AssociationRobotTelecomStrasbourg/effective-pancake/hardware/pdf/effective-pancake-lidar.pdf

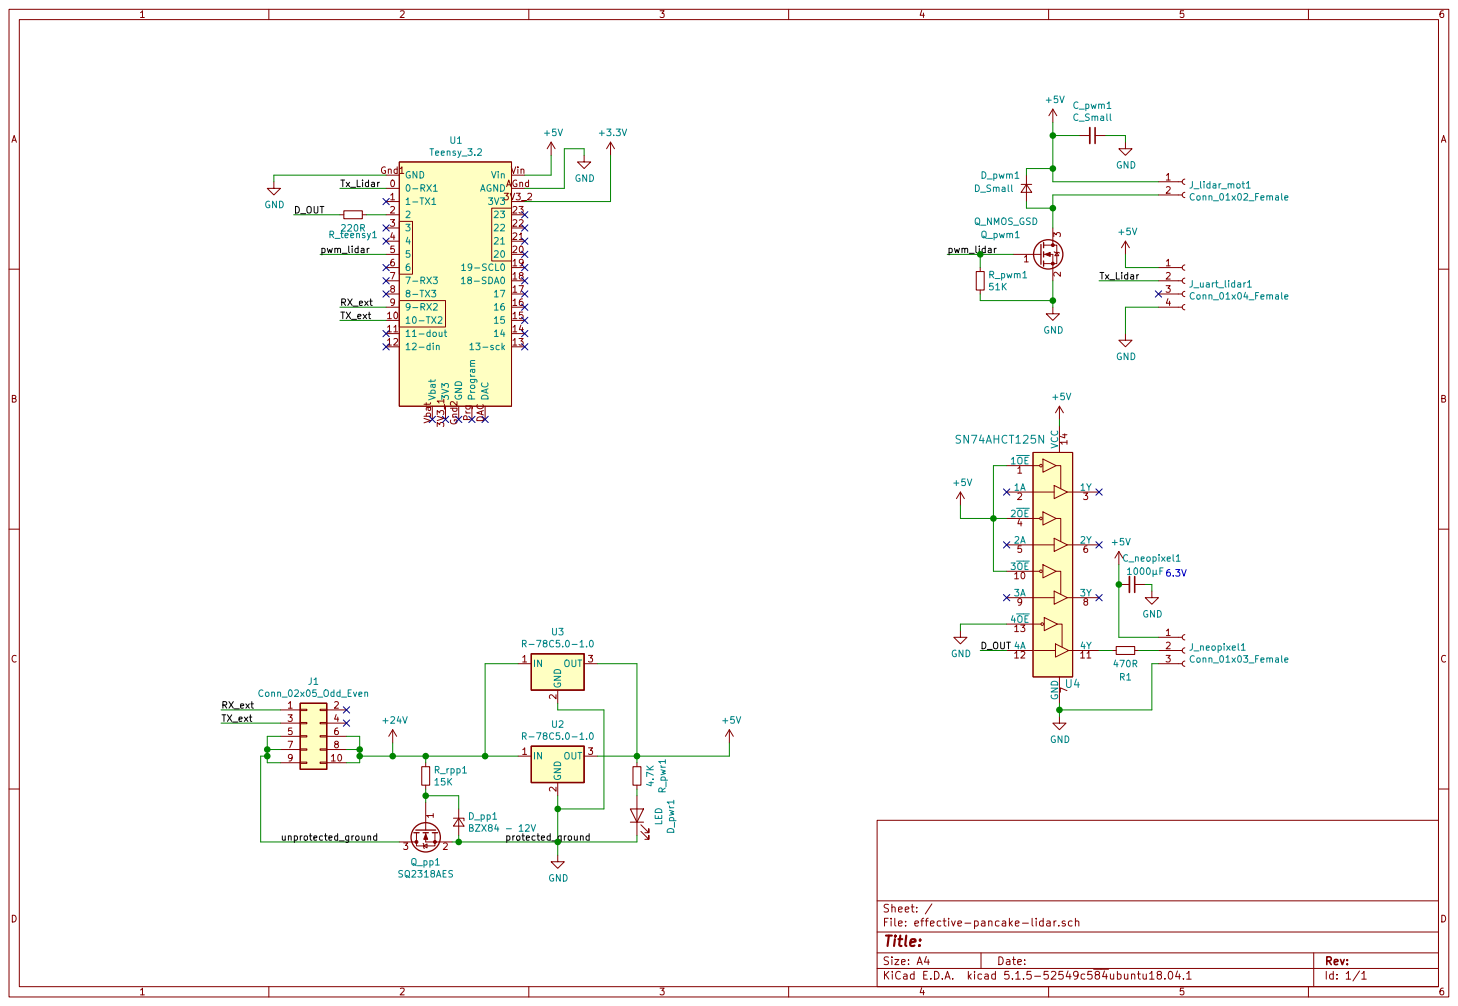
[picture p1: page 1]

File: effective-pancake-lidar.sch Sheet: /
