AssociationRobotTelecomStrasbourg/effective-pancake/hardware/pdf/effective-pancake-motherboard.pdf

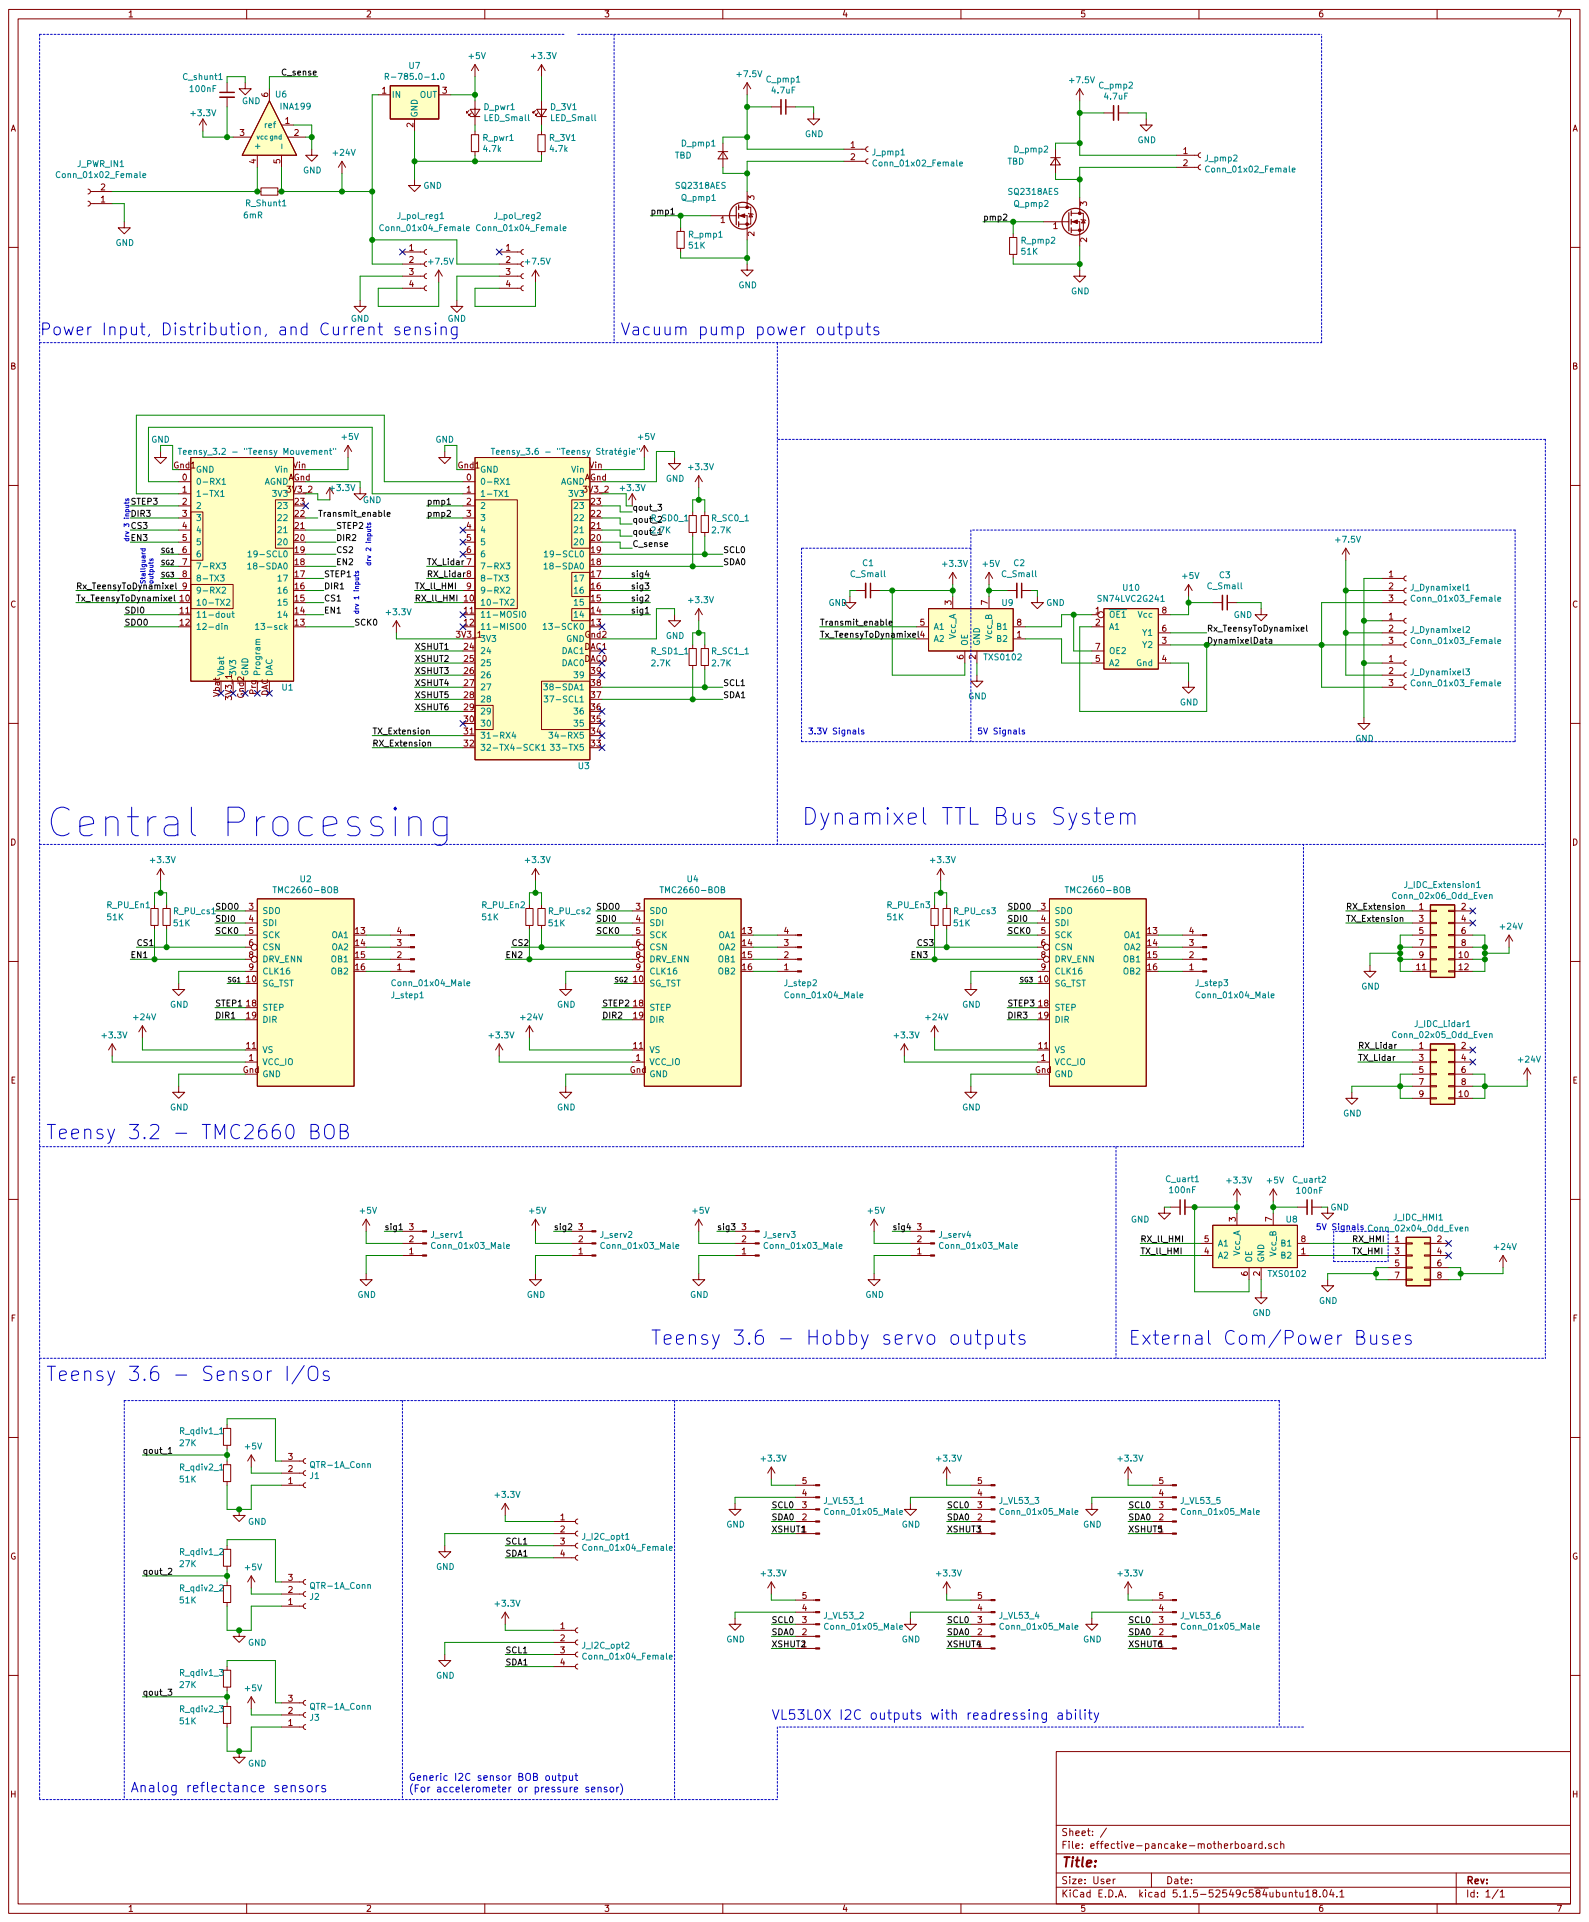
[picture p2: page 1]

Power Input, Distribution, and Current sensing drv 3 inputs

Vacuum pump power outputs

Teensy 3.6 - Hobby servo outputs drv 1 inputs

Dynamixel TTL Bus System

File: effective-pancake-motherboard.sch Sheet: / R_qdiv2_1

VL53L0X I2C outputs with readressing ability
