AssociationRobotTelecomStrasbourg/effective-pancake/hardware/pdf/effective-pancake-HMI.pdf

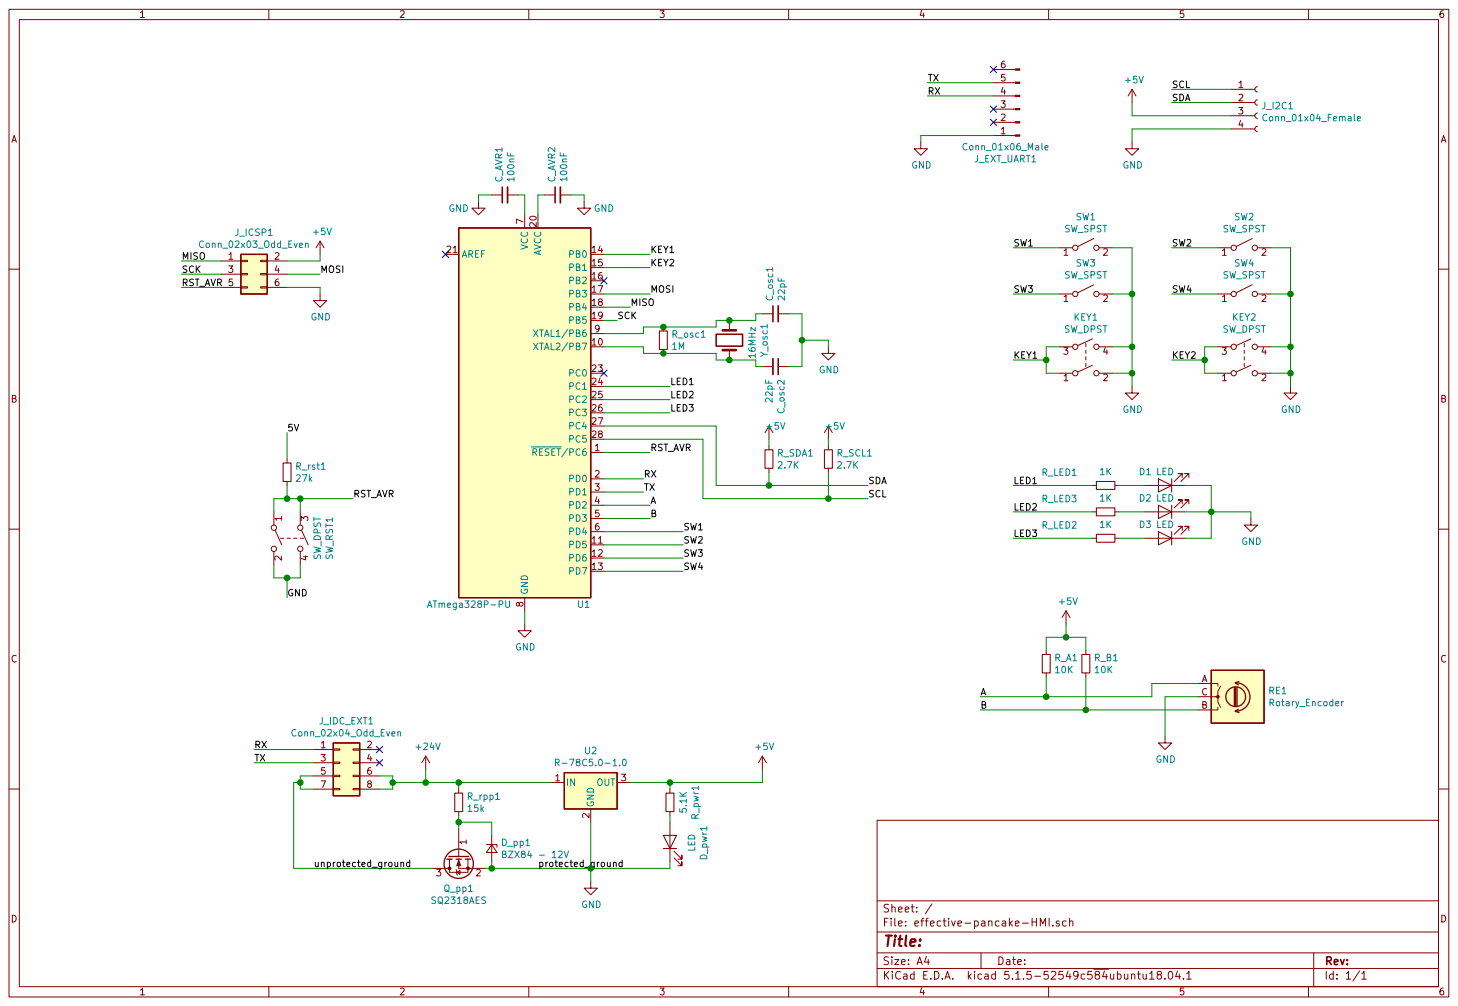
[picture p3: page 1]

File: effective-pancake-HMI.sch Sheet: /
Id: 1/1 Title:
