AssociationRobotTelecomStrasbourg/effective-pancake/hardware/effective-pancake-motherboard/effective-pancake-motherboard.kicad_pcb

## KiCad design hardware/effective-pancake-motherboard/effective-pancake-motherboard.kicad_pcb (2020-01-04)

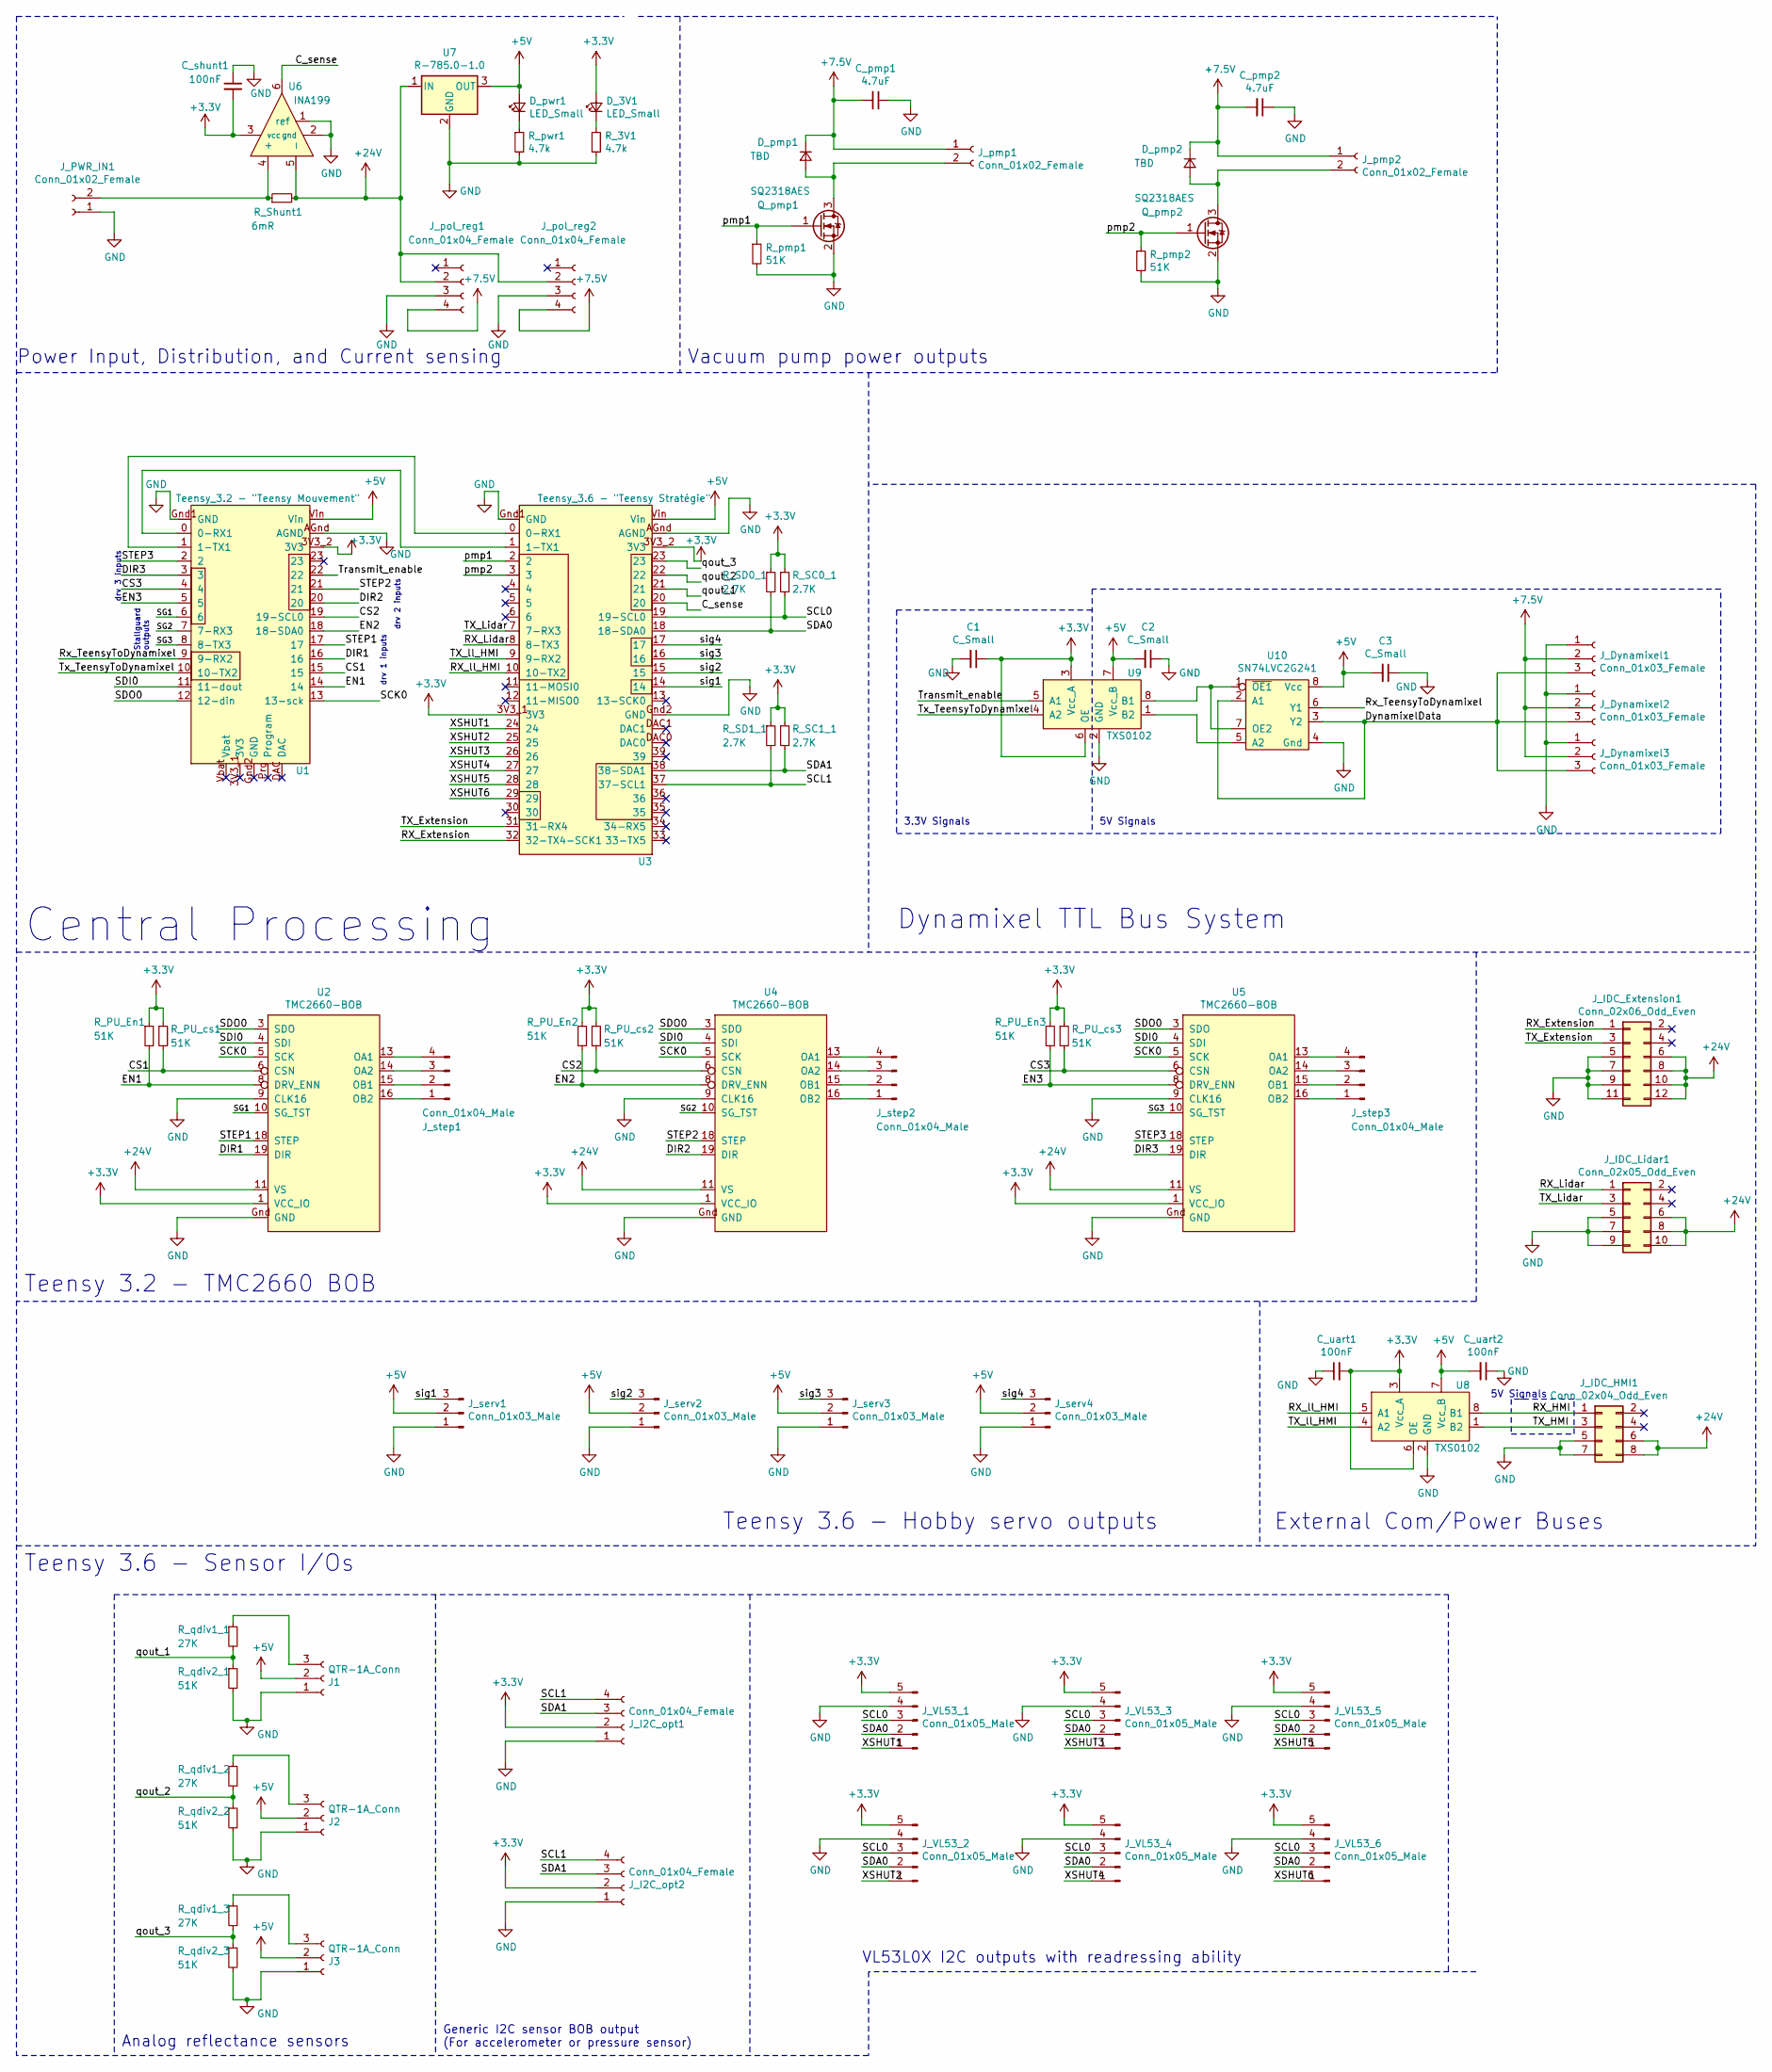
[picture p4: schematic effective-pancake-motherboard.sch]

Parts:
C1, C2, C3: C_Small; C_0805_2012Metric_Pad1.15x1.40mm_HandSolder
C_pmp1, C_pmp2: 4.7uF; C_Radial_D4.0mm_H7.0mm_P1.50mm
C_shunt1: 100nF; C_0805_2012Metric_Pad1.15x1.40mm_HandSolder
C_uart1, C_uart2: 100nF; C_0805_2012Metric_Pad1.15x1.40mm_HandSolder
D_3V1: LED_Small; LED_1206_3216Metric_Castellated
D_pmp1, D_pmp2: TBD; D_1206_3216Metric
D_pwr1: LED_Small; LED_1206_3216Metric_Castellated
J1, J2, J3: QTR-1A_Conn; PinHeader_1x03_P2.54mm_Vertical
J_Dynamixel1, J_Dynamixel2, J_Dynamixel3: Conn_01x03_Female; Molex_Micro-Latch_53253-0370_1x03_P2.00mm_Vertical
J_I2C_opt1, J_I2C_opt2: Conn_01x04_Female; PinSocket_1x04_P2.54mm_Vertical
J_IDC_Extension1: Conn_02x06_Odd_Even; IDC-Header_2x06_P2.54mm_Vertical
J_IDC_HMI1: Conn_02x04_Odd_Even; IDC-Header_2x04_P2.54mm_Vertical
J_IDC_Lidar1: Conn_02x05_Odd_Even; IDC-Header_2x05_P2.54mm_Vertical
J_PWR_IN1: Conn_01x02_Female; PhoenixContact_MC_1,5_2-G-5.08_1x02_P5.08mm_Horizontal
J_VL53_1, J_VL53_2, J_VL53_3, J_VL53_4, J_VL53_5, J_VL53_6: Conn_01x05_Male; PinSocket_1x05_P2.54mm_Vertical
J_pmp1, J_pmp2: Conn_01x02_Female; JST_XH_B2B-XH-A_1x02_P2.50mm_Vertical
J_pol_reg1, J_pol_reg2: Conn_01x04_Female; PinSocket_1x04_P2.54mm_Vertical
J_serv1, J_serv2, J_serv3, J_serv4: Conn_01x03_Male; PinHeader_1x03_P2.54mm_Vertical
J_step1, J_step2, J_step3: Conn_01x04_Male; PinHeader_1x04_P2.54mm_Vertical
Q_pmp1, Q_pmp2: SQ2318AES; SOT-23
R_3V1: 4.7k; R_0805_2012Metric_Pad1.15x1.40mm_HandSolder
R_PU_En1, R_PU_En2, R_PU_En3: 51K; R_0805_2012Metric_Pad1.15x1.40mm_HandSolder
R_PU_cs1, R_PU_cs2, R_PU_cs3: 51K; R_0805_2012Metric_Pad1.15x1.40mm_HandSolder
R_SC0_1, R_SC1_1: 2.7K; R_0805_2012Metric_Pad1.15x1.40mm_HandSolder
R_SD0_1, R_SD1_1: 2.7K; R_0805_2012Metric_Pad1.15x1.40mm_HandSolder
R_Shunt1: 6mR; R_1206_3216Metric_Pad1.42x1.75mm_HandSolder
R_pmp1, R_pmp2: 51K; R_0805_2012Metric_Pad1.15x1.40mm_HandSolder
R_pwr1: 4.7k; R_0805_2012Metric_Pad1.15x1.40mm_HandSolder
R_qdiv1_1, R_qdiv1_2, R_qdiv1_3: 27K; R_0805_2012Metric_Pad1.15x1.40mm_HandSolder
R_qdiv2_1, R_qdiv2_2, R_qdiv2_3: 51K; R_0805_2012Metric_Pad1.15x1.40mm_HandSolder
U1: Teensy_3.2 - \"Teensy Mouvement\"; Teensy_3.2
U2, U4, U5: TMC2660-BOB
U3: Teensy_3.6 - \"Teensy Stratégie\"; Teensy_3.6
U6: INA199; Texas_R-PDSO-G6
U7: R-785.0-1.0; Converter_DCDC_RECOM_R-78E-0.5_THT
U8, U9: TXS0102; PDSO-G8
U10: SN74LVC2G241; PDSO-G8

Connections:
+3V3: C1.1, C_shunt1.2, C_uart1.2, D_3V1.2 (A), J_I2C_opt1.2, J_I2C_opt2.2, J_VL53_1.5, J_VL53_2.5, J_VL53_3.5, J_VL53_4.5, J_VL53_5.5, J_VL53_6.5, R_PU_En1.1, R_PU_En2.1, R_PU_En3.1, R_PU_cs1.1, R_PU_cs2.1, R_PU_cs3.1, R_SC0_1.1, R_SC1_1.1, R_SD0_1.1, R_SD1_1.1, U1.3V3_2 (3V3), U2.1 (VCC_IO), U3.3V3_1 (3V3), U3.3V3_2 (3V3), U4.1 (VCC_IO), U5.1 (VCC_IO), U6.3 (vcc), U8.3 (Vcc_A), U8.6 (OE), U9.3 (Vcc_A), U9.6 (OE)
+5V: C2.2, C3.2, C_uart2.2, D_pwr1.2 (A), J1.2, J2.2, J3.2, J_serv1.2, J_serv2.2, J_serv3.2, J_serv4.2, U1.Vin, U3.Vin, U7.3 (OUT), U8.7 (Vcc_B), U9.7 (Vcc_B), U10.8 (Vcc)
+7.5V: C_pmp1.2, C_pmp2.2, D_pmp1.1 (K), D_pmp2.1 (K), J_Dynamixel1.2, J_Dynamixel2.2, J_Dynamixel3.2, J_pmp1.1, J_pmp2.1, J_pol_reg1.4, J_pol_reg2.4
+24V: J_IDC_Extension1.6, J_IDC_Extension1.8, J_IDC_Extension1.10, J_IDC_Extension1.12, J_IDC_HMI1.6, J_IDC_HMI1.8, J_IDC_Lidar1.6, J_IDC_Lidar1.8, J_IDC_Lidar1.10, J_pol_reg1.2, J_pol_reg2.2, R_Shunt1.2, U2.11 (VS), U4.11 (VS), U5.11 (VS), U6.5 (-), U7.1 (IN)
/CS1: R_PU_cs1.2, U1.15, U2.6 (CSN)
/CS2: R_PU_cs2.2, U1.19 (19-SCL0), U4.6 (CSN)
/CS3: R_PU_cs3.2, U1.4, U5.6 (CSN)
/C_sense: U3.20, U6.6
/DIR1: U1.16, U2.19 (DIR)
/DIR2: U1.20, U4.19 (DIR)
/DIR3: U1.3, U5.19 (DIR)
/DynamixelData: J_Dynamixel1.3, J_Dynamixel2.3, J_Dynamixel3.3, U10.2 (A1), U10.3 (Y2)
/EN1: R_PU_En1.2, U1.14, U2.8 (DRV_ENN)
/EN2: R_PU_En2.2, U1.18 (18-SDA0), U4.8 (DRV_ENN)
/EN3: R_PU_En3.2, U1.5, U5.8 (DRV_ENN)
/RX_Extension: J_IDC_Extension1.1, U3.32 (32-TX4-SCK1)
/RX_HMI: J_IDC_HMI1.1, U8.8 (B1)
/RX_Lidar: J_IDC_Lidar1.1, U3.8 (8-TX3)
/RX_ll_HMI: U3.10 (10-TX2), U8.5 (A1)
/Rx_TeensyToDynamixel: U1.9 (9-RX2), U10.6 (Y1)
/SCK0: U1.13 (13-sck), U2.5 (SCK), U4.5 (SCK), U5.5 (SCK)
/SCL0: J_VL53_1.3, J_VL53_2.3, J_VL53_3.3, J_VL53_4.3, J_VL53_5.3, J_VL53_6.3, R_SC0_1.2, U3.19 (19-SCL0)
/SCL1: J_I2C_opt1.4, J_I2C_opt2.4, R_SD1_1.2, U3.37 (37-SCL1)
/SDA0: J_VL53_1.2, J_VL53_2.2, J_VL53_3.2, J_VL53_4.2, J_VL53_5.2, J_VL53_6.2, R_SD0_1.2, U3.18 (18-SDA0)
/SDA1: J_I2C_opt1.3, J_I2C_opt2.3, R_SC1_1.2, U3.38 (38-SDA1)
/SDI0: U1.11 (11-dout), U2.4 (SDI), U4.4 (SDI), U5.4 (SDI)
/SDO0: U1.12 (12-din), U2.3 (SDO), U4.3 (SDO), U5.3 (SDO)
/SG1: U1.6, U2.10 (SG_TST)
/SG2: U1.7 (7-RX3), U4.10 (SG_TST)
/SG3: U1.8 (8-TX3), U5.10 (SG_TST)
/STEP1: U1.17, U2.18 (STEP)
/STEP2: U1.21, U4.18 (STEP)
/STEP3: U1.2, U5.18 (STEP)
/TX_Extension: J_IDC_Extension1.3, U3.31 (31-RX4)
/TX_HMI: J_IDC_HMI1.3, U8.1 (B2)
/TX_Lidar: J_IDC_Lidar1.3, U3.7 (7-RX3)
/TX_ll_HMI: U3.9 (9-RX2), U8.4 (A2)
/Transmit_enable: U1.22, U9.5 (A1)
/Tx_TeensyToDynamixel: U1.10 (10-TX2), U9.4 (A2)
/XSHUT1: J_VL53_1.1, U3.24
/XSHUT2: J_VL53_2.1, U3.25
/XSHUT3: J_VL53_3.1, U3.26
/XSHUT4: J_VL53_4.1, U3.27
/XSHUT5: J_VL53_5.1, U3.28
/XSHUT6: J_VL53_6.1, U3.29
/pmp1: Q_pmp1.1 (G), R_pmp1.1, U3.2
/pmp2: Q_pmp2.1 (G), R_pmp2.1, U3.3
/qout_1: R_qdiv1_1.2, R_qdiv2_1.1, U3.21
/qout_2: R_qdiv1_2.2, R_qdiv2_2.1, U3.22
/qout_3: R_qdiv1_3.2, R_qdiv2_3.1, U3.23
/sig1: J_serv1.3, U3.14
/sig2: J_serv2.3, U3.15
/sig3: J_serv3.3, U3.16
/sig4: J_serv4.3, U3.17
GND: C1.2, C2.1, C3.1, C_pmp1.1, C_pmp2.1, C_shunt1.1, C_uart1.1, C_uart2.1, J1.1, J2.1, J3.1, J_Dynamixel1.1, J_Dynamixel2.1, J_Dynamixel3.1, J_I2C_opt1.1, J_I2C_opt2.1, J_IDC_Extension1.5, J_IDC_Extension1.7, J_IDC_Extension1.9, J_IDC_Extension1.11, J_IDC_HMI1.5, J_IDC_HMI1.7, J_IDC_Lidar1.5, J_IDC_Lidar1.7, J_IDC_Lidar1.9, J_PWR_IN1.1, J_VL53_1.4, J_VL53_2.4, J_VL53_3.4, J_VL53_4.4, J_VL53_5.4, J_VL53_6.4, J_pol_reg1.3, J_pol_reg2.3, J_serv1.1, J_serv2.1, J_serv3.1, J_serv4.1, Q_pmp1.2 (S), Q_pmp2.2 (S), R_3V1.2, R_pmp1.2, R_pmp2.2, R_pwr1.2, R_qdiv2_1.2, R_qdiv2_2.2, R_qdiv2_3.2, U1.AGnd (AGND), U1.Gnd1 (GND), U2.9 (CLK16), U2.Gnd (GND), U3.AGnd (AGND), U3.Gnd1 (GND), U3.Gnd2 (GND), U4.9 (CLK16), U4.Gnd (GND), U5.9 (CLK16), U5.Gnd (GND), U6.1 (ref), U6.2 (gnd), U7.2 (GND), U8.2 (GND), U9.2 (GND), U10.4 (Gnd)
unnamed: D_3V1.1 (K), R_3V1.1
unnamed: D_pmp1.2 (A), J_pmp1.2, Q_pmp1.3 (D)
unnamed: D_pmp2.2 (A), J_pmp2.2, Q_pmp2.3 (D)
unnamed: D_pwr1.1 (K), R_pwr1.1
unnamed: J1.3, R_qdiv1_1.1
unnamed: J2.3, R_qdiv1_2.1
unnamed: J3.3, R_qdiv1_3.1
unnamed: J_PWR_IN1.2, R_Shunt1.1, U6.4 (+)
unnamed: J_step1.1, U2.16 (OB2)
unnamed: J_step1.2, U2.15 (OB1)
unnamed: J_step1.3, U2.14 (OA2)
unnamed: J_step1.4, U2.13 (OA1)
unnamed: J_step2.1, U4.16 (OB2)
unnamed: J_step2.2, U4.15 (OB1)
unnamed: J_step2.3, U4.14 (OA2)
unnamed: J_step2.4, U4.13 (OA1)
unnamed: J_step3.1, U5.16 (OB2)
unnamed: J_step3.2, U5.15 (OB1)
unnamed: J_step3.3, U5.14 (OA2)
unnamed: J_step3.4, U5.13 (OA1)
unnamed: U1.0 (0-RX1), U3.1 (1-TX1)
unnamed: U1.1 (1-TX1), U3.0 (0-RX1)
unnamed: U9.8 (B1), U10.1 (~OE1), U10.7 (OE2)
unnamed: U9.1 (B2), U10.5 (A2)

Notes on the sheet:
5V Signals
drv 1 inputs
drv 2 inputs
drv 3 inputs
Stallguard outputs
Teensy 3.2 - TMC2660 BOB
Teensy 3.6 - Sensor I/Os
Analog reflectance sensors
Generic I2C sensor BOB output (For accelerometer or pressure sensor)
VL53L0X I2C outputs with readressing ability
Teensy 3.6 - Hobby servo outputs
Central Processing
Power Input, Distribution, and Current sensing
External Com/Power Buses
Vacuum pump power outputs
Dynamixel TTL Bus System
3.3V Signals

Board: 2 copper layers, 74 parts (0 on the bottom side), 79 nets, no tracks yet.
