AssociationRobotTelecomStrasbourg/effective-pancake/include/board.h

#ifndef BOARD_H
#define BOARD_H

#include <Arduino.h>

// Hardware Serial port 1, connected to ESP01
#define RX1 0
#define TX1 1

// Tactile Switch input
#define BTN 23

// Pins for Driver 1, 2 and 3
#define DIR1 8
#define STEP1 9
#define EN1 10

#define DIR2 5
#define STEP2 6
#define EN2 7

#define DIR3 2
#define STEP3 3
#define EN3 4

void waitForButton();

#endif
