AssociationRobotTelecomStrasbourg/effective-pancake/(commit log)

2019-12-12 Added TeensyStep lib
2020-01-01 hardware file structure & ongoing CAD
    [effective-pancake-HMI.kicad_pcb, effective-pancake-HMI.sch, effective-pancake-lidar.kicad_pcb, effective-pancake-lidar.sch, effective-pancake-motherboard.kicad_pcb, effective-pancake-motherboard.sch, effective-pancake-power-management.kicad_pcb, effective-pancake-power-management.sch]
2020-01-04 Finished schematics, fp association, and verifications.
    [bss138-shifter.sch, effective-pancake-HMI.sch, effective-pancake-lidar.sch, effective-pancake-motherboard.kicad_pcb, effective-pancake-motherboard.sch]
